cshieldsce/riscv-5i/docs/setup/index.md

---
layout: default
title: Setup
permalink: /setup/
---

# Setup

Quickstart for building, simulating, and synthesizing `riscv-5`. Tested on Ubuntu 22.04 and Fedora; other Linux distros should work with equivalent package names.

## Dependencies {#dependencies}

The repo needs an open-source HDL toolchain (Icarus Verilog, GTKWave), a RISC-V GCC cross-compiler, RISCOF, and Xilinx Vivado for the FPGA path.

```bash
sudo apt-get update
sudo apt-get install -y iverilog gtkwave python3 python3-pip git
sudo apt-get install gcc-riscv64-unknown-elf
pip3 install riscof
```

Vivado is a separate install from Xilinx (free WebPACK edition is enough for the Zynq-7000 target). Tested with {{ site.results.toolchain }}.

## Clone and bootstrap {#clone}

```bash
git clone https://github.com/cshieldsce/riscv-5.git
cd riscv-5
./setup_project.sh
```

`setup_project.sh` clones the [RISC-V architectural test suite](https://github.com/riscv-non-isa/riscv-arch-test) into `test/verification/riscv-arch-test/` and verifies that `riscv64-unknown-elf-gcc` is on your PATH.

Sanity check:

```bash
iverilog -v
riscv64-unknown-elf-gcc --version
riscof --version
ls test/verification/riscv-arch-test/
```

## Simulation {#simulation}

A single test, with a memory image:

```bash
cd test/tb
iverilog -g2012 -I ../../src/ -o sim.out \
    ../../src/riscv_pkg.sv \
    ../../src/*.sv \
    pipelined_cpu_tb.sv
vvp sim.out +TEST=../mem/fib_test.mem
gtkwave waveform.vcd
```

The `+TEST=` plus-arg points at a `.mem` initialization file under [`test/mem/`](https://github.com/cshieldsce/riscv-5/tree/main/test/mem). Drop in any RV32I program assembled to that format and the testbench runs it through the pipeline; the VCD writes to `waveform.vcd` for GTKWave.

To compile and run from the repo root instead of `test/tb`:

```bash
iverilog -g2012 -o sim.out -I src/ src/pipelined_cpu.sv test/tb/pipelined_cpu_tb.sv
vvp sim.out +TEST=test/mem/fib_test.mem
```

## Compliance run {#compliance}

The full RISCOF suite against Spike runs end-to-end in one script:

```bash
./test/verification/run_compliance.sh
```

The HTML report lands in `test/verification/riscof_work/report.html`. Plugins for the DUT and golden model live under [`test/verification/compliance/`](https://github.com/cshieldsce/riscv-5/tree/main/test/verification/compliance) if you want to swap out targets.

## FPGA build {#fpga-deployment}

The Vivado project is generated by a TCL script that lives under `fpga/`:

```bash
cd fpga
vivado -mode batch -source create_project.tcl
```

From there, synthesize, implement, and program the board through the Vivado GUI or its TCL prompt. The PYNQ-Z2 top-level wiring (LEDs, clock, reset) lives in [`src/pynq_z2_top.sv`](https://github.com/cshieldsce/riscv-5/blob/main/src/pynq_z2_top.sv); the synthesis and timing results are on the [FPGA]({{ '/fpga/' | relative_url }}) page.
