cshieldsce/riscv-5i/docs/_includes/results-strip.html

{{ site.results.riscof_rv32i_pass }}/{{ site.results.riscof_rv32i_total }} RISCOF RV32I pass against {{ site.results.riscof_golden_model }}

{{ site.results.lut }} LUTs ({{ site.results.lut_pct }} of {{ site.results.fpga_target }})

{% if site.results.fmax_mhz != "TBD" %}

{{ site.results.fmax_mhz }} MHz fmax (closed at {{ site.results.clock_target_mhz }} MHz, WNS {{ site.results.wns_ns }} ns)

{% endif %}

{{ site.results.riscof_regression_pass }}/{{ site.results.riscof_regression_total }} Regression suite on every commit
