cshieldsce/riscv-5i/(commit log)

2026-05-31 Stop wrapping stage subsections in side-by-side; figure flows above
2026-09-14 feat: Add sv2v conversion script for the Sky130 flow
